INiKkEI/led-cube/(list of files, drawings)

Other design files:
hardware/led-cube/led-cube.PcbLib
hardware/led-cube/led-cube.PrjPcb
hardware/led-cube/led-cube.SchDoc
hardware/led-cube/led-cube.SchLib
