INiKkEI/led-cube/(commit log)

2026-07-28 Add requirements traceability matrix
2026-07-28 Add system specifications; rewrite REQ-17 for a 5 V bare board
2026-07-28 Add system test plan; drop joint pull-force spec
2026-07-28 Add system architecture; switch to reverse-parallel diode protection
2026-07-28 Add pin assignment
2026-07-28 Add power budget
2026-07-29 Rename cathode nets to LAY; single 470 uF bulk capacitor
2026-07-29 Add Altium project: schematic and libraries
    [led-cube.PcbLib, led-cube.PrjPcb, led-cube.SchDoc, led-cube.SchLib]
2026-08-03 Add power integrity analysis, board and mounting ADRs; withdraw SPEC-34; correct SOIC-16 and LED Vf assumptions
2026-10-16 Add README with overview, status, key figures and PCB render
2026-10-31 Add schematic and PCB layout images to README
    Added schematic and PCB layout images to README.
